hugelton/BirdsBoard/Hardware/BirdsBoardSchematic.pdf

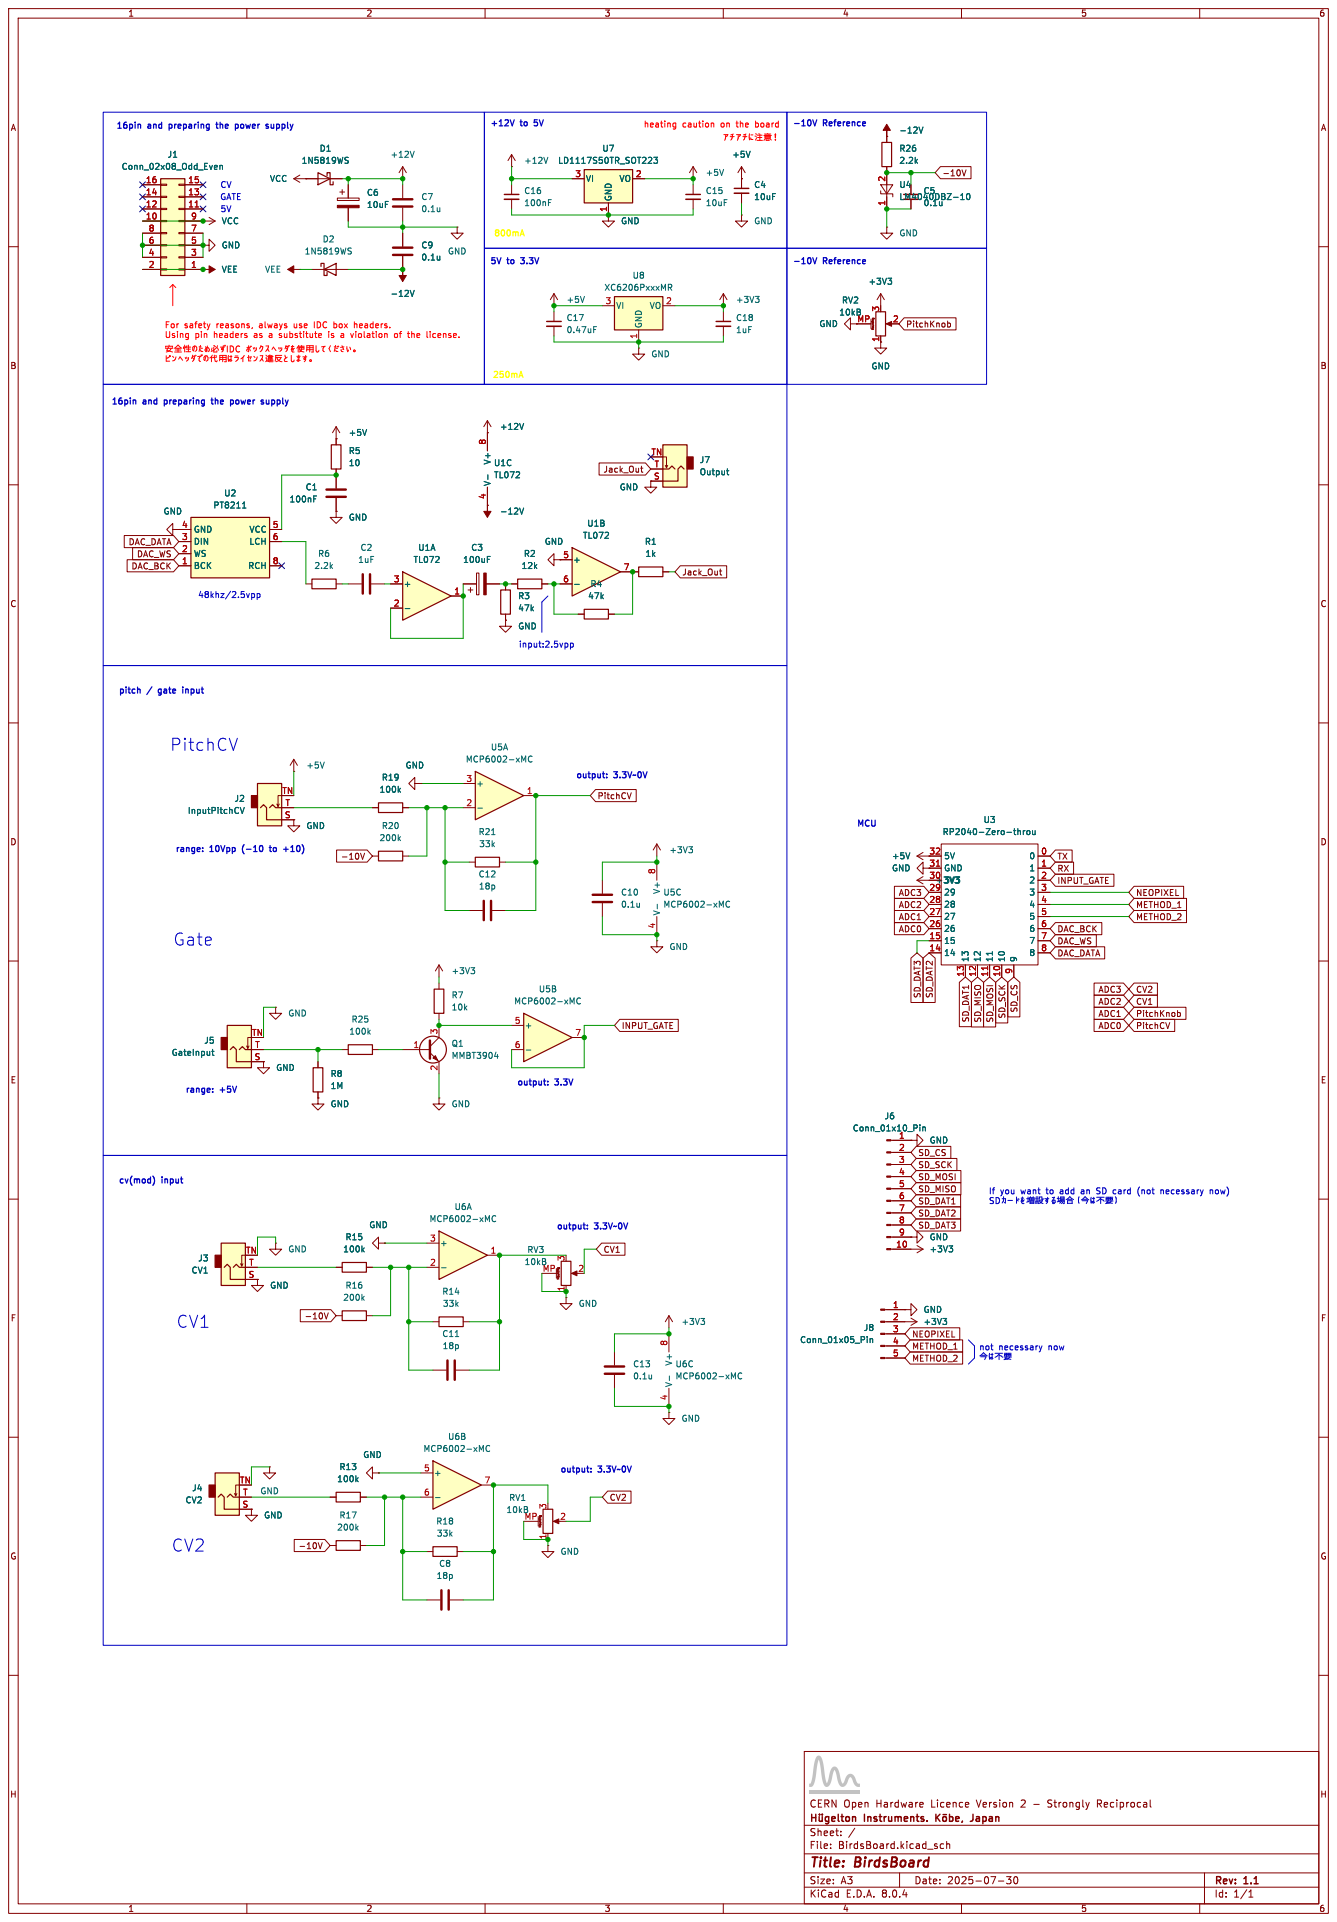
[picture p1: page 1]

16pin and preparing the power supply GATE CV

1 VO 2 VI 3 VCC GND C9

8 U5C MCP6002-xMC GND GND Mounting 1

16pin and preparing the power supply
