hugelton/BirdsBoard/Hardware/BirdsBoard.kicad_pcb

## KiCad design Hardware/BirdsBoard.kicad_pcb (2025-07-30)

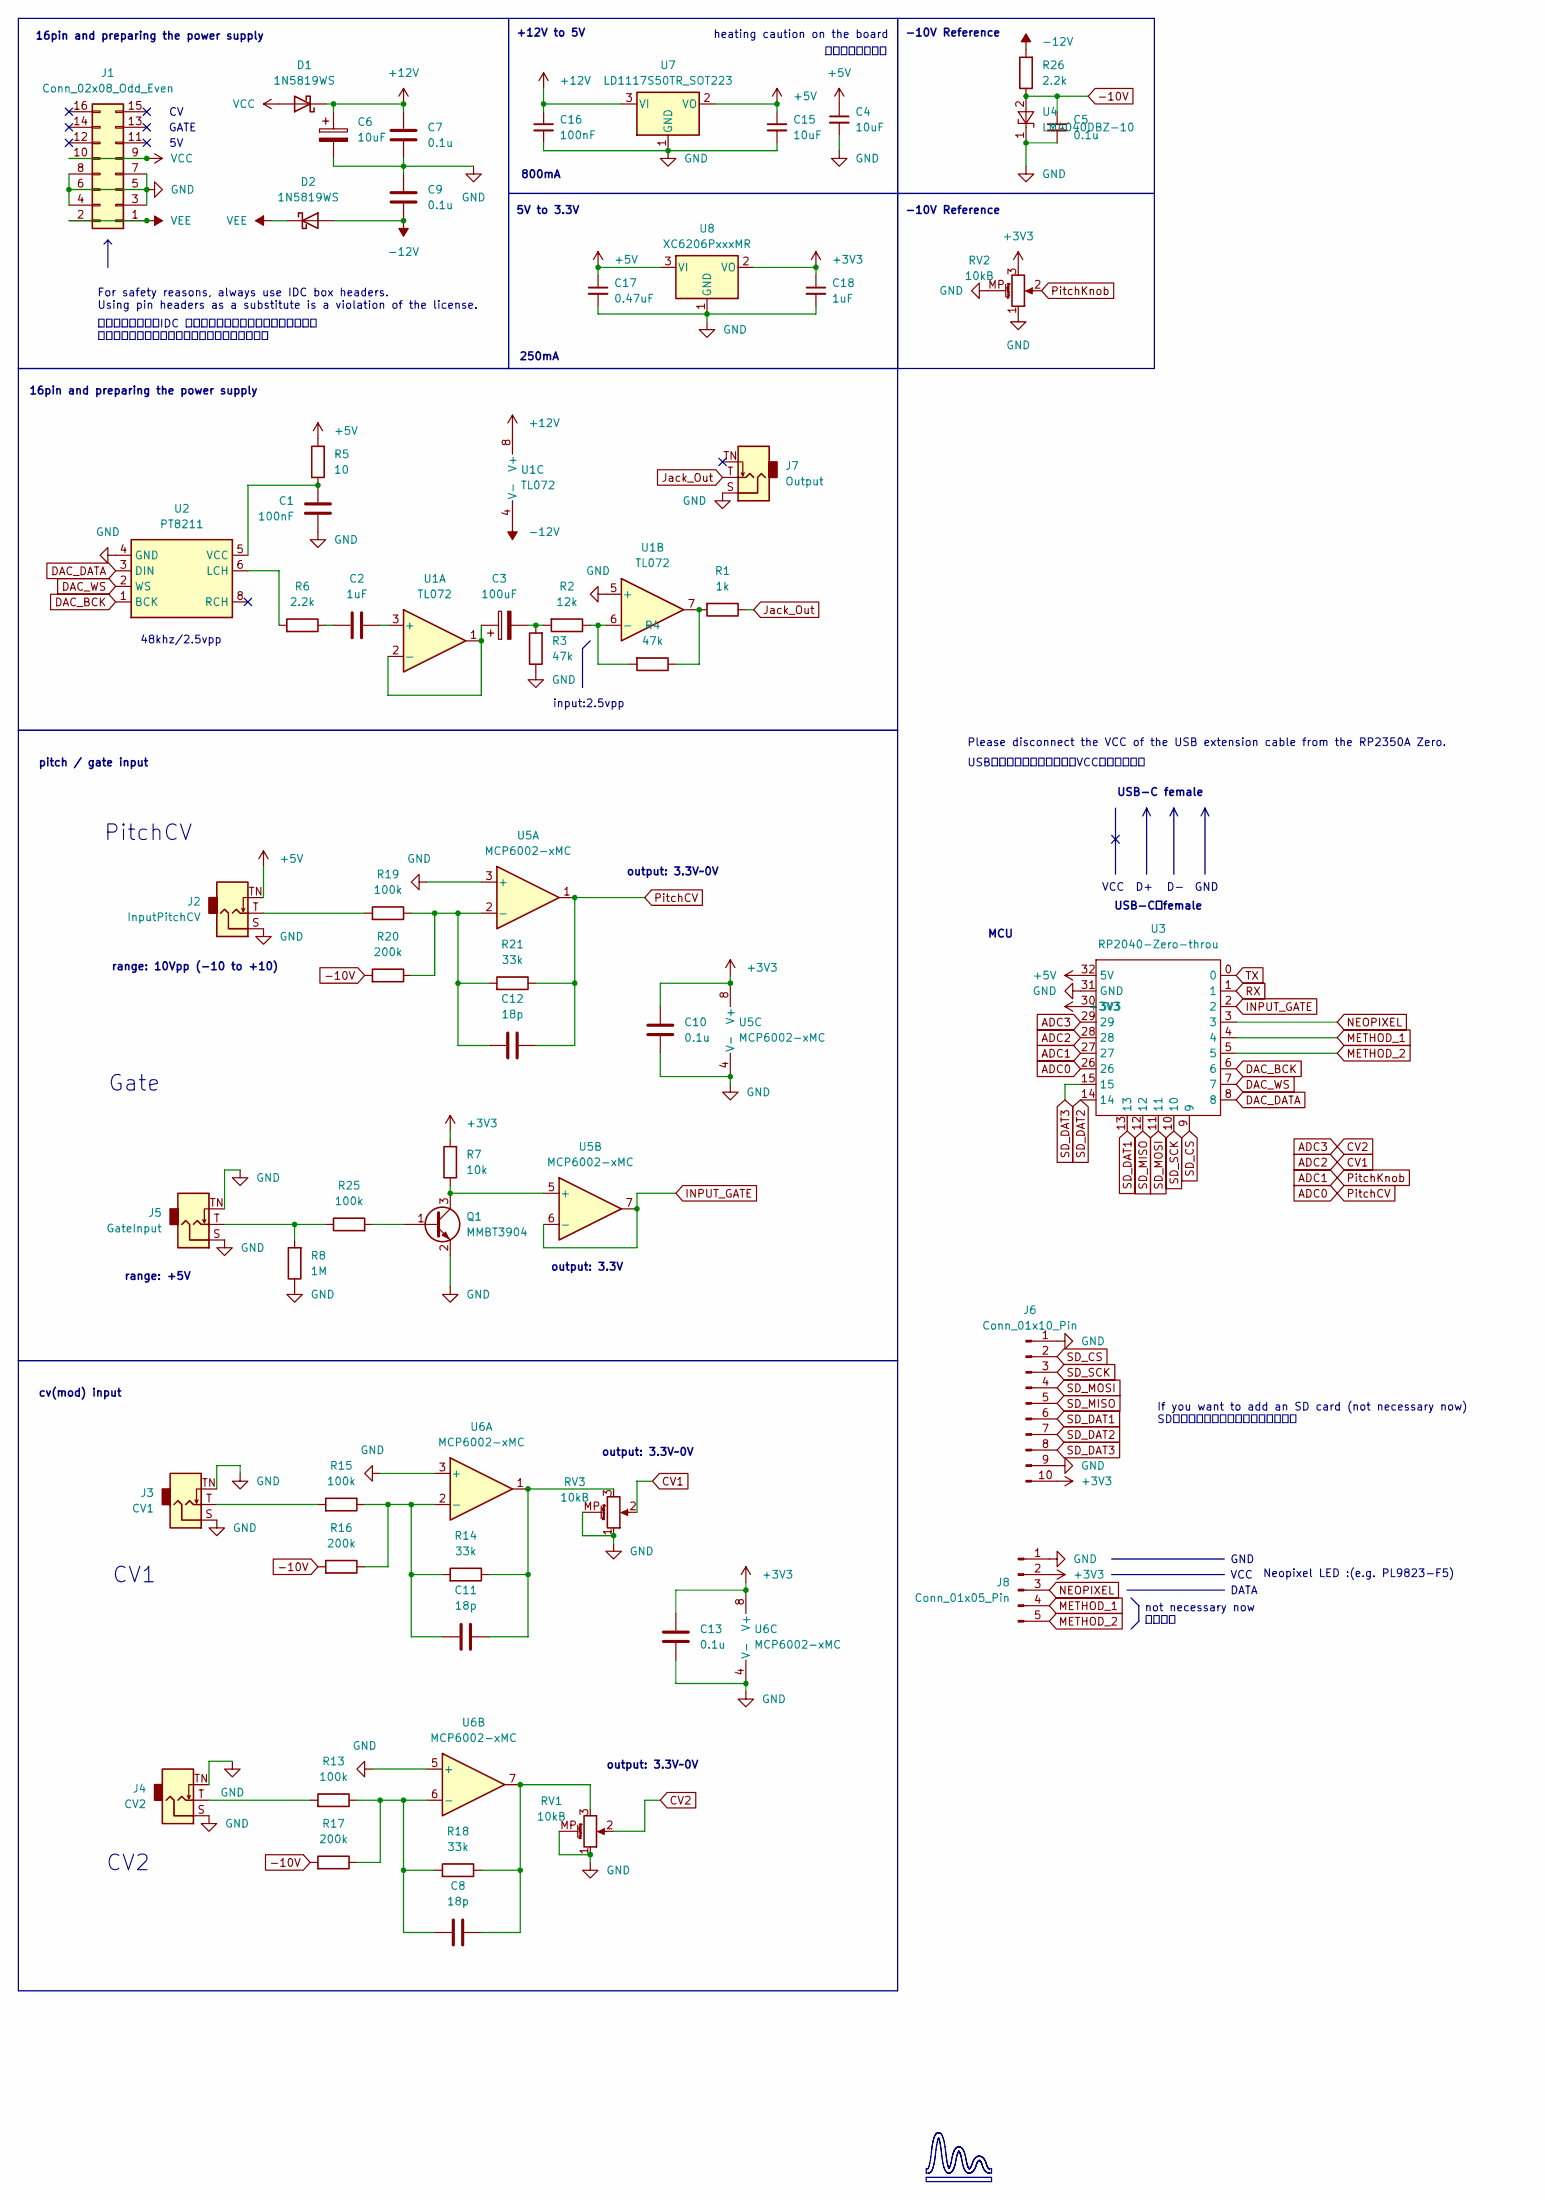
[picture p2: schematic BirdsBoard.kicad_sch]

Parts:
C1: 100nF; C_0603_1608Metric_Pad1.08x0.95mm_HandSolder
C2: 1uF; C_0603_1608Metric_Pad1.08x0.95mm_HandSolder
C3: 100uF; CP_Elec_6.3x5.4_Nichicon
C4, C15: 10uF; C_0603_1608Metric; JLCPCB C85713
C5: 0.1u; C_0402_1005Metric; JLCPCB C105526
C6: 10uF; C_0805_2012Metric_Pad1.18x1.45mm_HandSolder; JLCPCB C85713
C7, C9: 0.1u; C_0603_1608Metric; JLCPCB C14663
C8, C11, C12: 18p; C_0402_1005Metric
C10, C13: 0.1u; C_0402_1005Metric; JLCPCB C14663
C16: 100nF; C_0402_1005Metric; JLCPCB C282519
C17: 0.47uF; C_0402_1005Metric; JLCPCB C105526
C18: 1uF; C_0402_1005Metric; JLCPCB C1592
D1, D2: 1N5819WS; D_SOD-323
J1: Conn_02x08_Odd_Even; IDC-Header_2x08_P2.54mm_Vertical
J2: InputPitchCV; Thonk_narrowPad
J3: CV1; Thonk_narrowPad
J4: CV2; Thonk_narrowPad
J5: GateInput; Thonk_narrowPad
J6: Conn_01x10_Pin; PinHeader_1x10_P1.27mm_Vertical
J7: Output; Thonk_narrowPad
J8: Conn_01x05_Pin; PinHeader_1x05_P2.54mm_Vertical
Q1: MMBT3904; SOT-23
R1: 1k; R_0402_1005Metric
R2: 12k; R_0402_1005Metric
R3, R4: 47k; R_0402_1005Metric
R5: 10; R_0402_1005Metric
R6: 2.2k; R_0402_1005Metric
R7: 10k; R_0603_1608Metric_Pad0.98x0.95mm_HandSolder
R8: 1M; R_0603_1608Metric_Pad0.98x0.95mm_HandSolder
R13, R15, R19: 100k; R_0402_1005Metric
R14, R18, R21: 33k; R_0402_1005Metric
R16, R17, R20: 200k; R_0402_1005Metric
R25: 100k; R_0603_1608Metric_Pad0.98x0.95mm_HandSolder
R26: 2.2k; R_0603_1608Metric_Pad0.98x0.95mm_HandSolder
RV1, RV2, RV3: 10kB; ALPS_RK09K_Single_Vertical_20mm
U1: TL072; SOIC-8_3.9x4.9mm_P1.27mm
U2: PT8211; SOP-8_3.76x4.96mm_P1.27mm
U3: RP2040-Zero-throu; RP2040-Zero-THT2
U4: LM4040DBZ-10; SOT-23
U5, U6: MCP6002-xMC; DFN-8-1EP_3x2mm_P0.5mm_EP1.75x1.45mm
U7: LD1117S50TR_SOT223; SOT-223-3_TabPin2; JLCPCB C6187
U8: XC6206PxxxMR; SOT-23-3; JLCPCB C5446

Connections:
+3V3: C10.1, C13.1, C18.1, J6.10, J8.2, R7.2, RV2.3, U3.30 (3V3), U5.8 (V+), U6.8 (V+), U8.2 (VO)
+5V: C4.1, C15.1, C17.1, J2.TN, R5.2, U3.32 (5V), U7.2 (VO), U8.3 (VI)
+12V: C6.1, C7.1, C16.1, D1.1 (K), U1.8 (V+), U7.3 (VI)
-10V: C5.1, R16.2, R17.2, R20.2, R26.1, U4.2 (A)
-12V: C9.2, D2.2 (A), R26.2, U1.4 (V-)
ADC0: C12.2, R21.1, U3.26, U5.1
ADC1: RV2.2, U3.27
ADC2: RV3.2, U3.28
ADC3: RV1.2, U3.29
DAC_BCK: U2.1 (BCK), U3.6
DAC_DATA: U2.3 (DIN), U3.8
DAC_WS: U2.2 (WS), U3.7
GND: C1.1, C4.2, C5.2, C6.2, C7.2, C9.1, C10.2, C13.2, C15.2, C16.2, C17.2, C18.2, J1.3, J1.4, J1.5, J1.6, J1.7, J1.8, J2.S, J3.S, J3.TN, J4.S, J4.TN, J5.S, J5.TN, J6.1, J6.9, J7.S, J8.1, Q1.2 (E), R3.1, R8.1, RV1.1, RV1.MP (MountPin), RV2.1, RV2.MP (MountPin), RV3.1, RV3.MP (MountPin), U1.5 (+), U2.4 (GND), U3.31 (GND), U4.1 (K), U5.3 (+), U5.4 (V-), U5.9 (V-), U6.3 (+), U6.4 (V-), U6.5 (+), U6.9 (V-), U7.1 (GND), U8.1 (GND)
INPUT_GATE: U3.2, U5.6 (-), U5.7
Jack_Out: J7.T, R1.1
METHOD_1: J8.4, U3.4
METHOD_2: J8.5, U3.5
NEOPIXEL: J8.3, U3.3
unnamed: C2.2, R6.1
unnamed: C3.2, R2.2, R3.2
unnamed: C8.2, R18.1, RV1.3, U6.7
unnamed: C11.2, R14.1, RV3.3, U6.1
unnamed: J2.T, R19.2
unnamed: J3.T, R15.2
unnamed: J4.T, R13.2
unnamed: J5.T, R8.2, R25.1
unnamed: Q1.1 (B), R25.2
unnamed: Q1.3 (C), R7.1, U5.5 (+)
unnamed: R1.2, R4.1, U1.7
unnamed: C2.1, U1.3 (+)
unnamed: C3.1, U1.1, U1.2 (-)
unnamed: R2.1, R4.2, U1.6 (-)
unnamed: R6.2, U2.6 (LCH)
unnamed: C1.2, R5.1, U2.5 (VCC)
unnamed: C12.1, R19.1, R20.1, R21.2, U5.2 (-)
unnamed: C11.1, R14.2, R15.1, R16.1, U6.2 (-)
unnamed: C8.1, R13.1, R17.1, R18.2, U6.6 (-)
RX: U3.1
SD_CS: J6.2, U3.9
SD_DAT1: J6.6, U3.13
SD_DAT2: J6.7, U3.14
SD_DAT3: J6.8, U3.15
SD_MISO: J6.5, U3.12
SD_MOSI: J6.4, U3.11
SD_SCK: J6.3, U3.10
TX: U3.0
VCC: D1.2 (A), J1.9, J1.10
VEE: D2.1 (K), J1.1, J1.2

Notes on the sheet:
CV1
not necessary now 今は不要
USB-C female
DATA
For safety reasons, always use IDC box headers. Using pin headers as a substitute is a violation of the license.
250mA
output: 3.3V
MCU
Neopixel LED :(e.g. PL9823-F5)
PitchCV
USBポートの延長ケーブルはVCCを切断します
800mA
input:2.5vpp
output: 3.3V~0V
heating caution on the board
cv(mod) input
GND
range: +5V
USB-C female
安全性のため必ずIDC ボックスヘッダを使用してください。 ピンヘッダでの代用はライセンス違反とします。
VCC
16pin and preparing the power supply
-10V Reference
Gate
48khz/2.5vpp
GATE
5V to 3.3V
Please disconnect the VCC of the USB extension cable from the RP2350A Zero.
CV2
If you want to add an SD card (not necessary now) SDカードを増設する場合（今は不要）
range: 10Vpp (-10 to +10)
アチアチに注意！
+12V to 5V
pitch / gate input

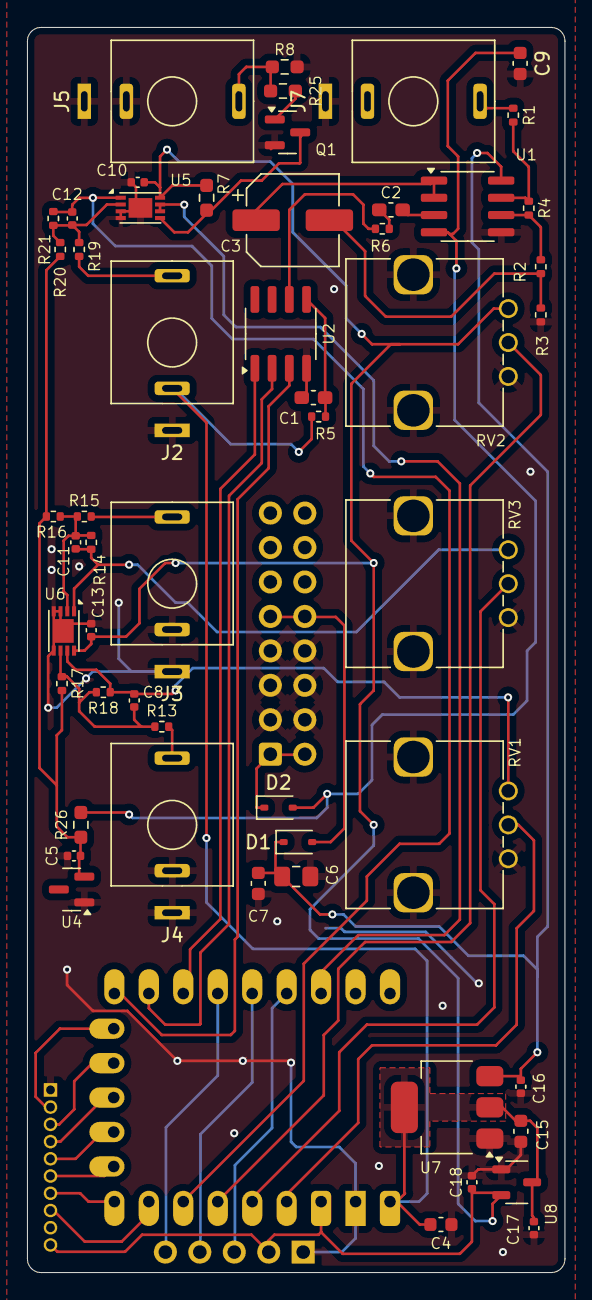
[picture p3: board BirdsBoard.kicad_pcb from above]

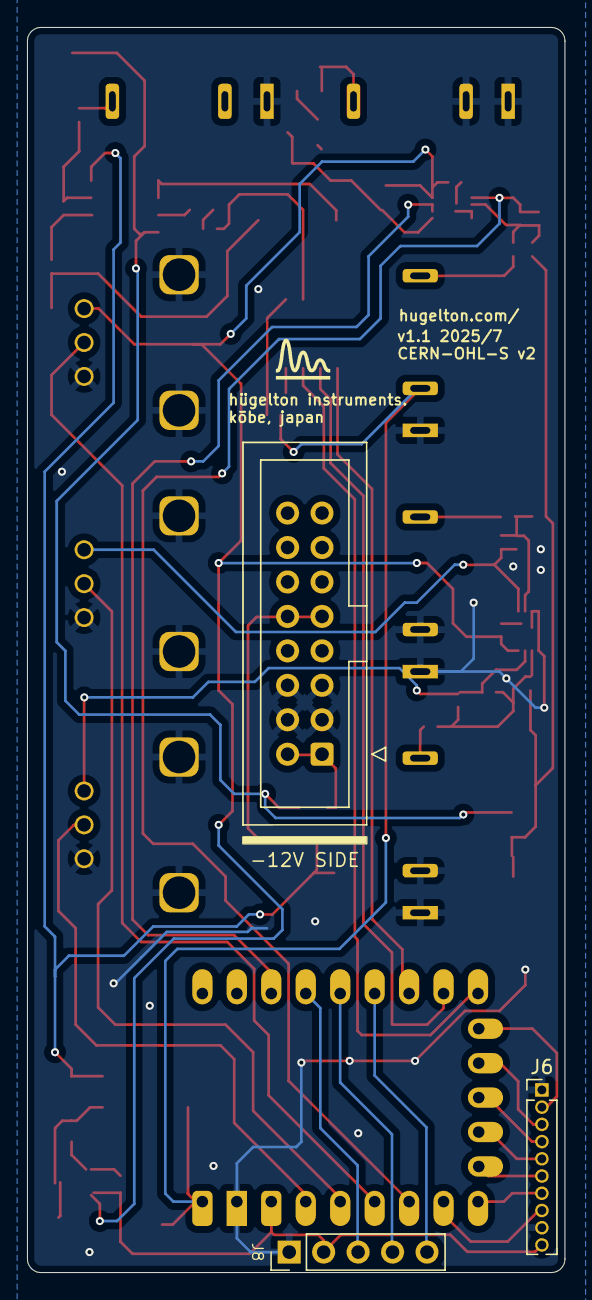
[picture p4: board BirdsBoard.kicad_pcb from below]

Board: 2 copper layers, 39.6 x 91.8 mm, 58 parts (4 on the bottom side), 46 nets.
