hugelton/BirdsBoard/(commit log)

2025-07-17 Initial commit: BirdsBoards Arduino synthesizer project
    - Wren: Real-time wavetable DCO with USB editing and NeoPixel display
    - Tern: LFSR noise oscillator
    - BirdsBoard_Test: Basic CV-controlled oscillator with waveform morphing
    - ADC_Test: Hardware debugging utility
    [ADC_Test.ino, Tern.ino, Tockus.ino, Wren.ino, audio_engine.cpp, audio_engine.h, audio_engine_v2.cpp, audio_engine_v2.h]
2025-07-30 First Release
    [BirdsBoard.kicad_pcb, BirdsBoard.kicad_sch, Wren_Panel.kicad_pcb, bom.csv, designators.csv, positions.csv]
2025-07-30 FUNDING.yml を更新
