hugelton/BirdsBoard/(notices)

Notices in the files:
Firmware/Tern/Tern.ino:
This program is free software: you can redistribute it and/or modify
it under the terms of the GNU Lesser General Public License as published by
the Free Software Foundation, either version 3 of the License, or
(at your option) any later version.
Hardware/BirdsBoard.kicad_sch:
CERN Open Hardware Licence Version 2 - Strongly Reciprocal
